VincentTUHH/uvms/testbench_construction/Vincent-3.dxf

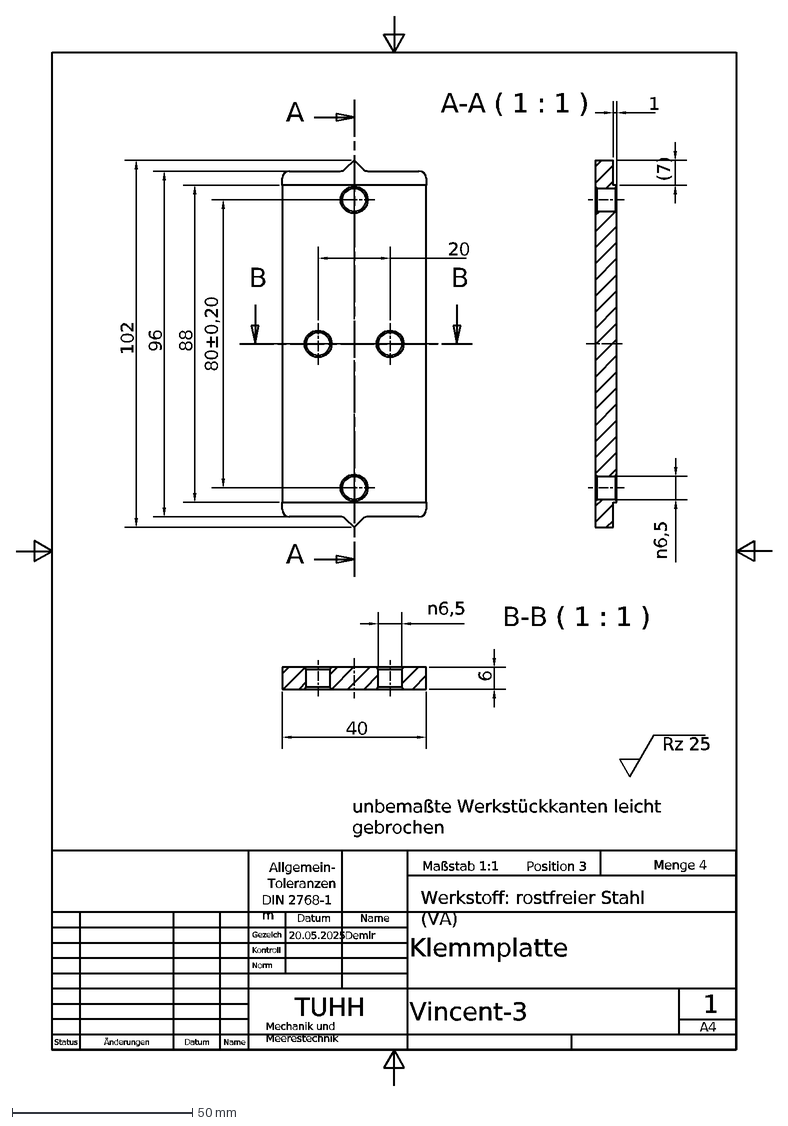
[picture p1: CAD file, 2025-09-16]
testbench_construction/Vincent-3.dxf
1
A4
Klemmplatte
Vincent-3
20.05.2025
Demir
Status
Änderungen
Datum
Name
Gezeich
Kontroll
Norm
80±0,20
20
102
96
A
A-A ( 1 : 1 )
(7)
88
B
B-B ( 1 : 1 )
6
Werkstoff: rostfreier Stahl (VA)
TUHH
DIN 2768-1 m
Maßstab 1:1
Toleranzen
Menge 4
Allgemein-
Position 3
Mechanik und Meerestechnik
unbemaßte Werkstückkanten leicht gebrochen
Rz 25
40
