VincentTUHH/uvms/testbench_construction/item_41901_profil-6-30x30-natur_600_hoch.step

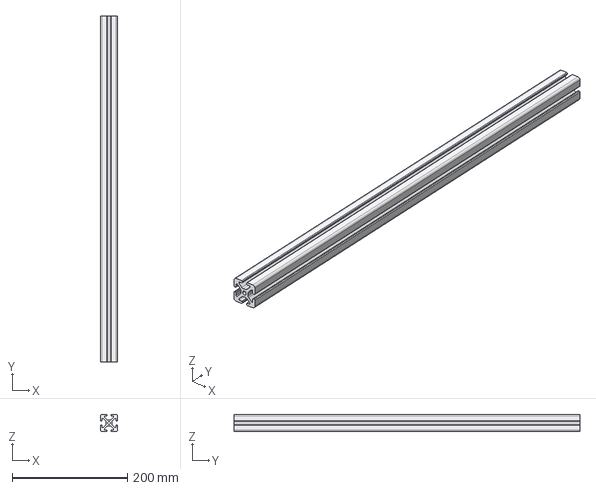
[picture p2: CAD file, 2025-09-16]
testbench_construction/item_41901_profil-6-30x30-natur_600_hoch.step
30.0 x 600.0 x 30.0 mm
