VincentTUHH/uvms/(list of files, cad)

Other CAD files:
testbench_construction/Vincent-4.dwg
testbench_construction/Vincent-1.dwg
testbench_construction/Vincent-8.dwg
testbench_construction/Vincent-5.dwg
testbench_construction/Vincent-6.dwg
testbench_construction/Vincent-2.dwg
testbench_construction/Vincent-7.dwg
testbench_construction/Abdeckkappe-40x40x4.ipt
testbench_construction/Deckel-1.ipt
testbench_construction/Deckel-2.ipt
testbench_construction/Fuss.iam
testbench_construction/Gleitbalken.ipt
testbench_construction/Hîhenverstellung-1.iam
testbench_construction/Hîhenverstellung-2.iam
testbench_construction/Klemmplatte.ipt
testbench_construction/Magnet.ipt
testbench_construction/Magnethalter.ipt
testbench_construction/Platte-1.ipt
testbench_construction/Platte-2.ipt
testbench_construction/Profil-40x40x1400.ipt
testbench_construction/Rasterbalken.ipt
testbench_construction/Referenzplatte.ipt
testbench_construction/Segment-Bodenplatte.ipt
testbench_construction/Teleskop-Hilfsvorrichtung.dwg
testbench_construction/Teleskop-Hilfsvorrichtung.iam
testbench_construction/Vincent-3.dwg
