VincentTUHH/uvms/testbench_construction/Vincent-1.pdf

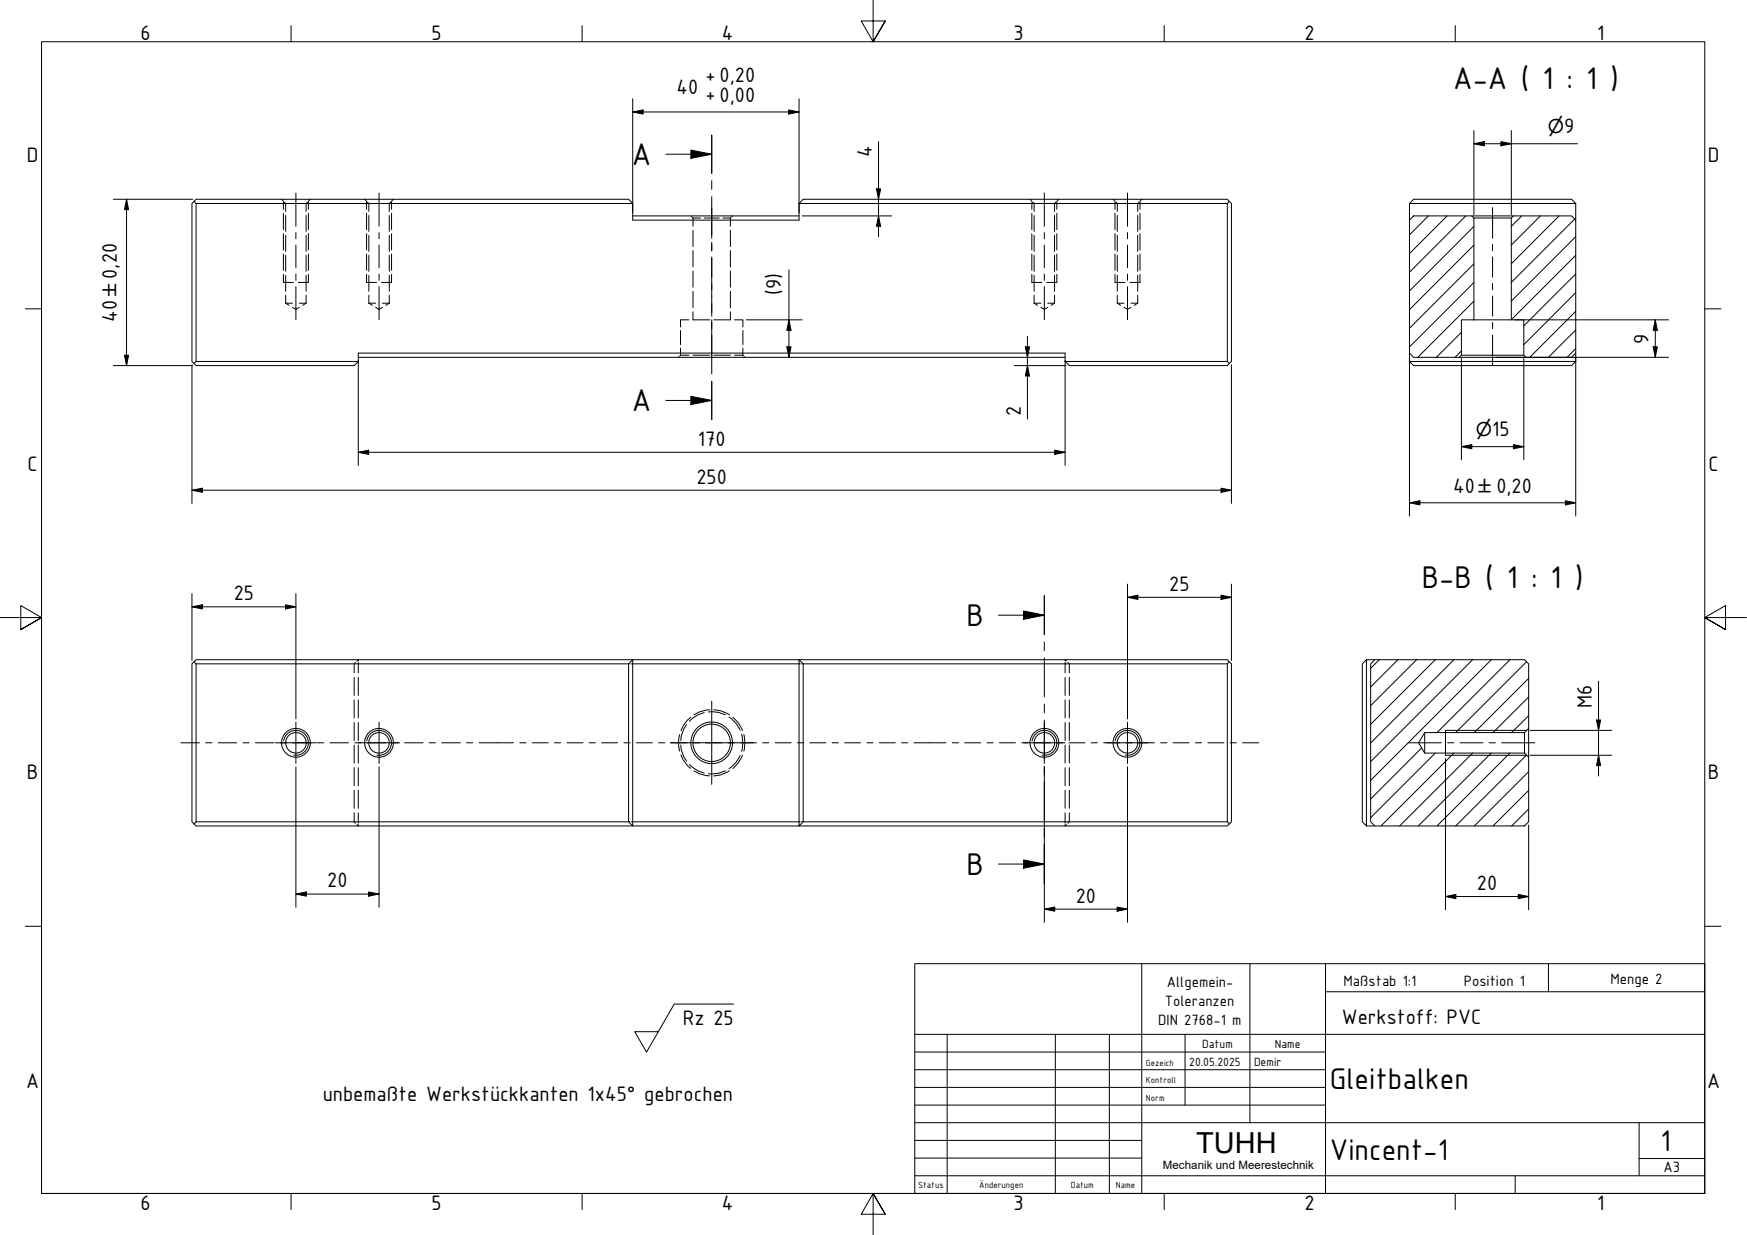
[picture p5: page 1]
DIN 2768-1 m; Maßstab 1:1; Position 1; Menge 2; Werkstoff: PVC

Datum | Name | Gleitbalken

Gezeich | 20.05.2025 | Demir

Kontroll

unbemaßte Werkstückkanten 1x45° gebrochen

Norm

Mechanik und Meerestechnik
