VincentTUHH/uvms/testbench_construction/Vincent-2.pdf

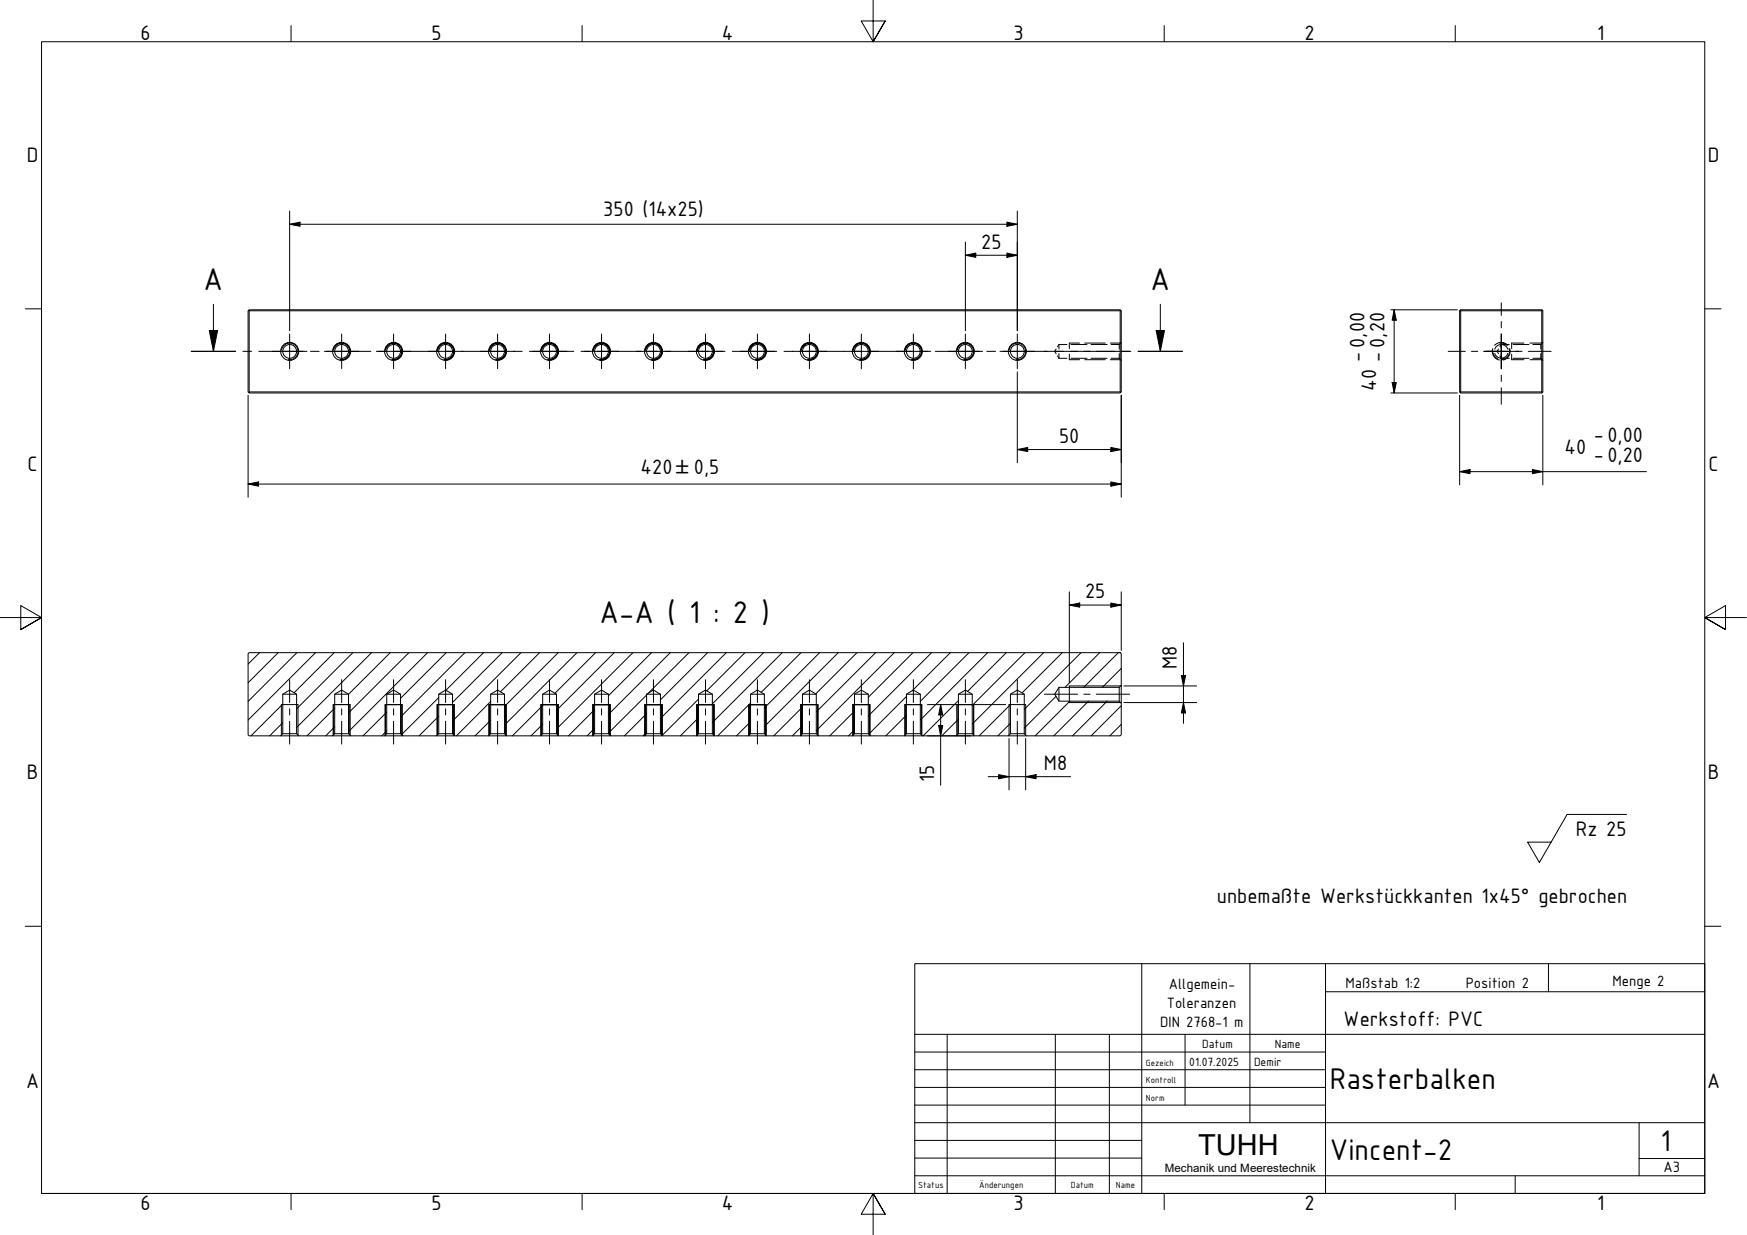
[picture p6: page 1]
Werkstoff: PVC; Menge 2; DIN 2768-1 m; Maßstab 1:2; Position 2

unbemaßte Werkstückkanten 1x45° gebrochen

Datum | Name | Rasterbalken

Gezeich | 01.07.2025 | Demir

Kontroll

Norm

Mechanik und Meerestechnik
