VincentTUHH/uvms/testbench_construction/Vincent-3.pdf

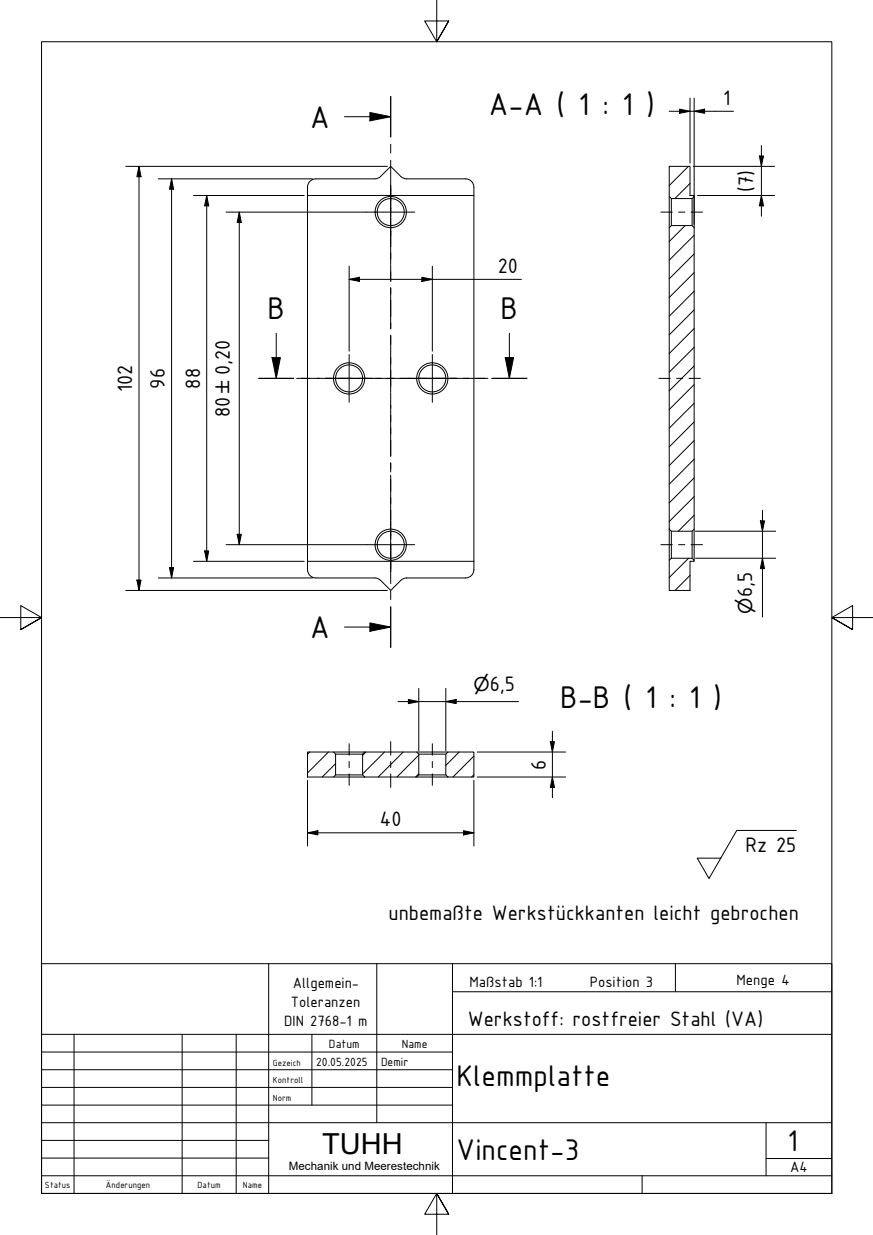
[picture p7: page 1]
DIN 2768-1 m; Allgemein-; Position 3; Menge 4

unbemaßte Werkstückkanten leicht gebrochen

Maßstab 1:1
Werkstoff: rostfreier Stahl (VA)

Datum | Name | Klemmplatte

Gezeich | 20.05.2025 | Demir

Kontroll

Norm

Mechanik und Meerestechnik
