VincentTUHH/uvms/testbench_construction/Vincent-4.pdf

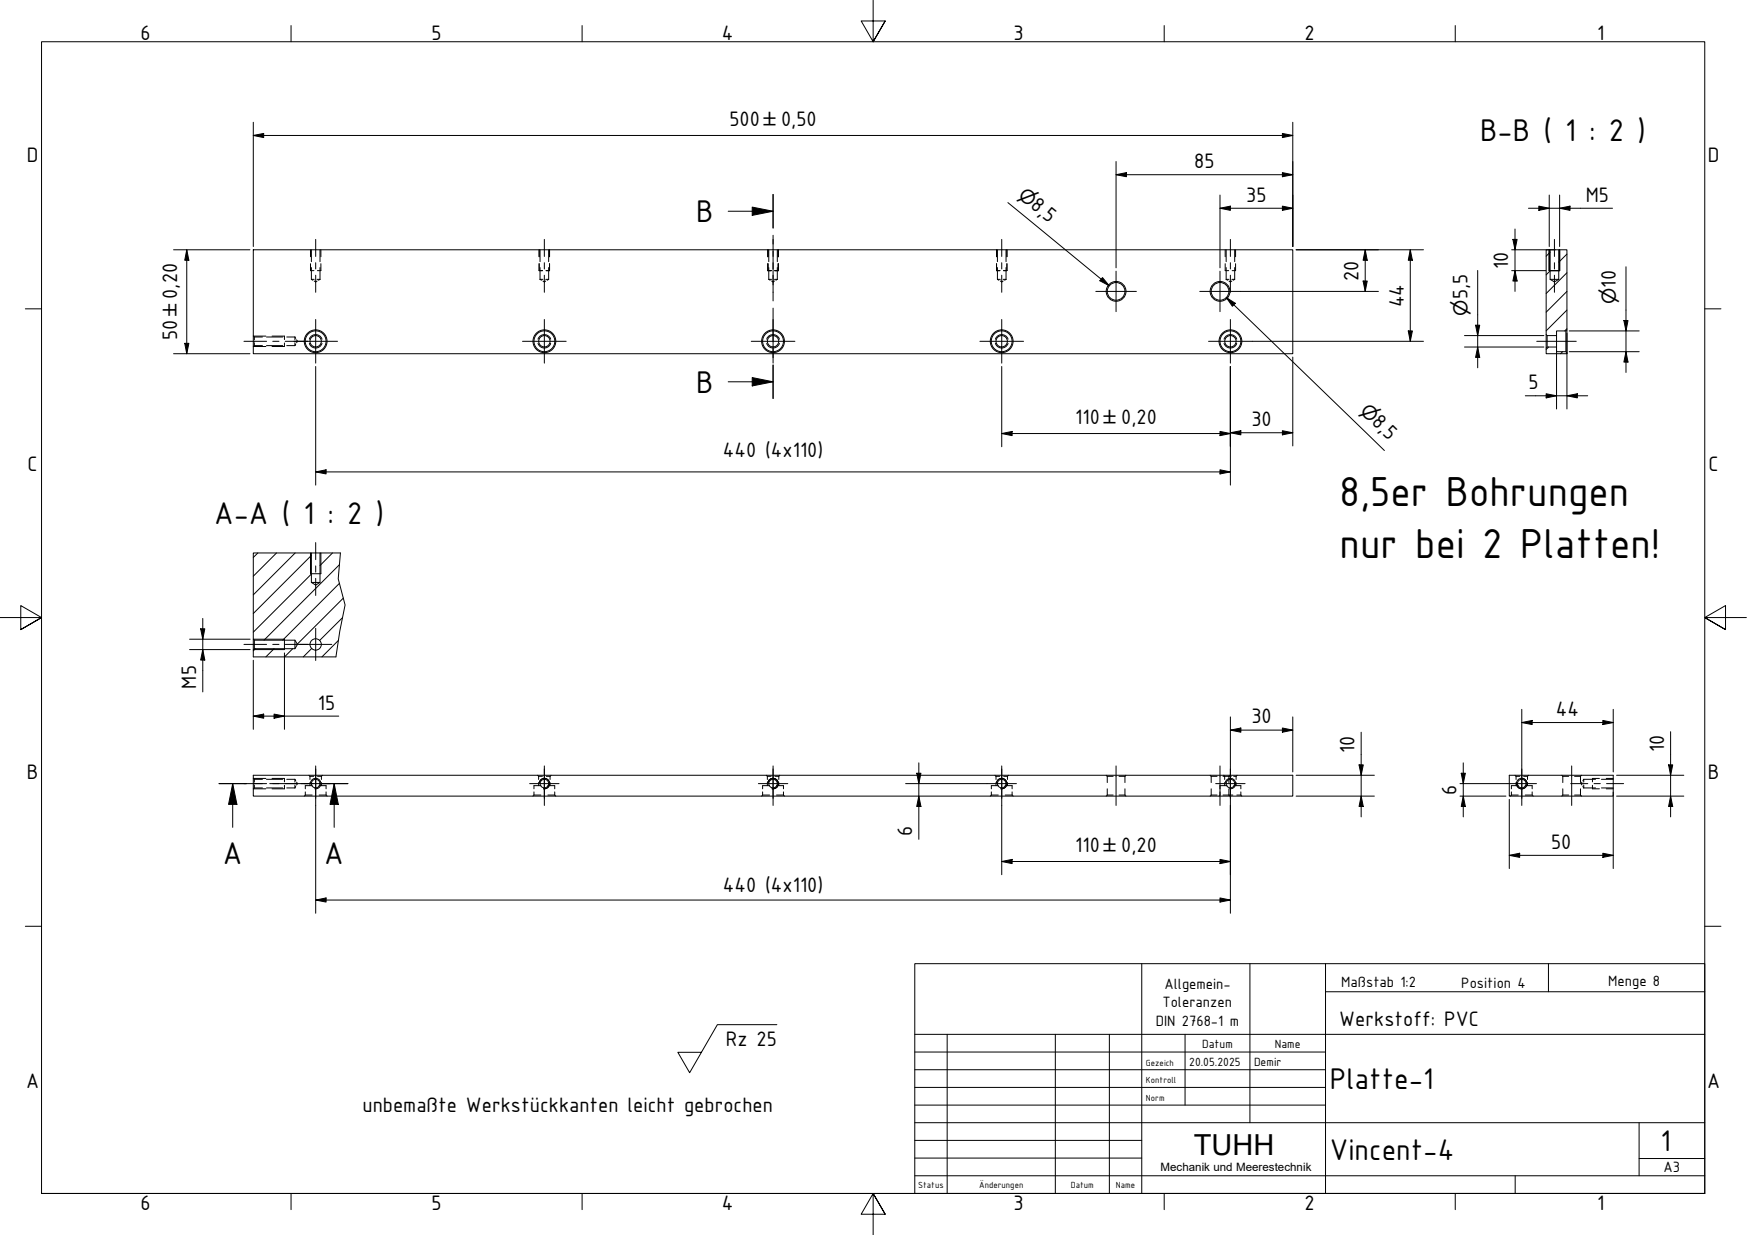
[picture p8: page 1]
DIN 2768-1 m; Werkstoff: PVC; Maßstab 1:2; Position 4; Menge 8

8,5er Bohrungen
nur bei 2 Platten!

Datum | Name | Platte-1

Gezeich | 20.05.2025 | Demir

Kontroll

Norm

unbemaßte Werkstückkanten leicht gebrochen

Mechanik und Meerestechnik
