VincentTUHH/uvms/testbench_construction/Vincent-5.pdf

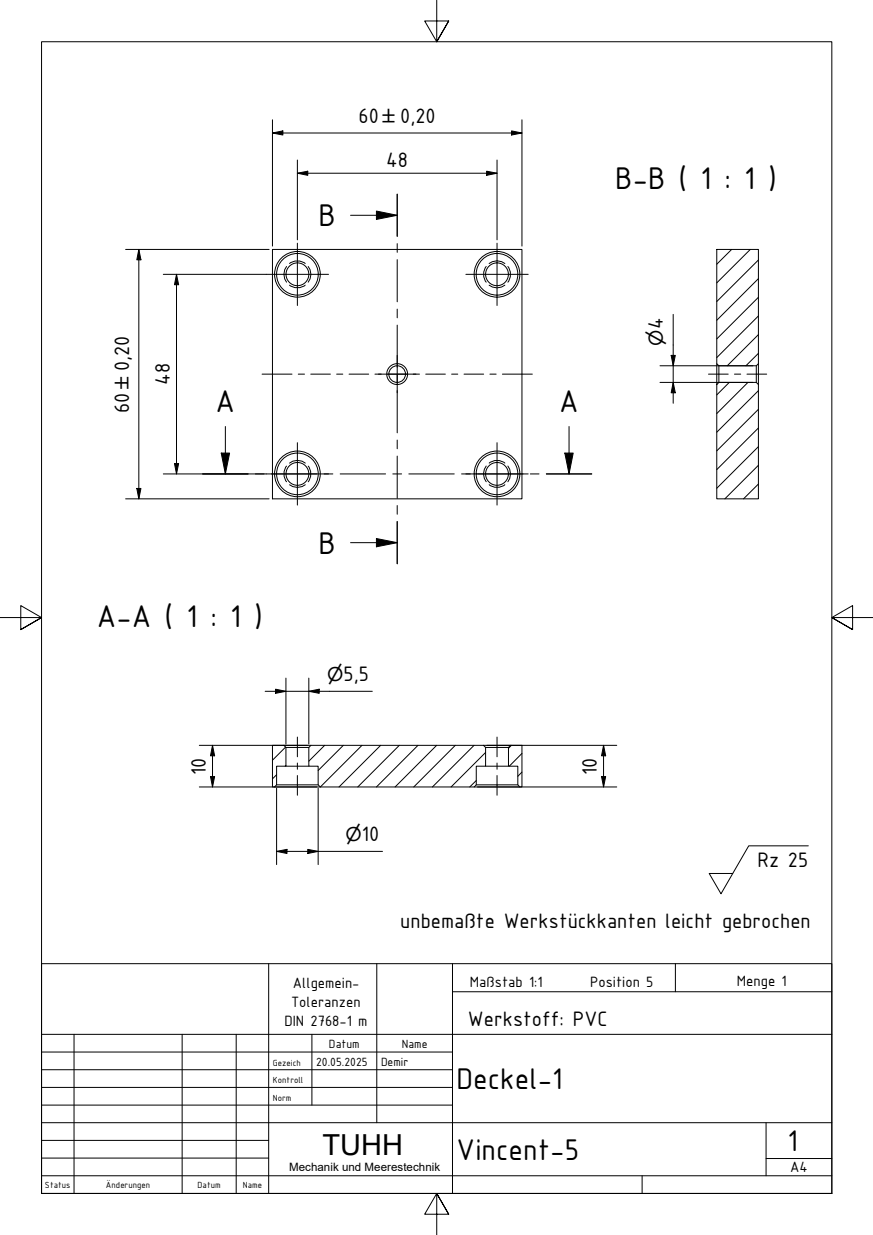
[picture p9: page 1]
DIN 2768-1 m; Werkstoff: PVC; Maßstab 1:1; Position 5; Menge 1

unbemaßte Werkstückkanten leicht gebrochen

Datum | Name | Deckel-1

Gezeich | 20.05.2025 | Demir

Kontroll

Norm

Mechanik und Meerestechnik
