VincentTUHH/uvms/testbench_construction/Vincent-6.pdf

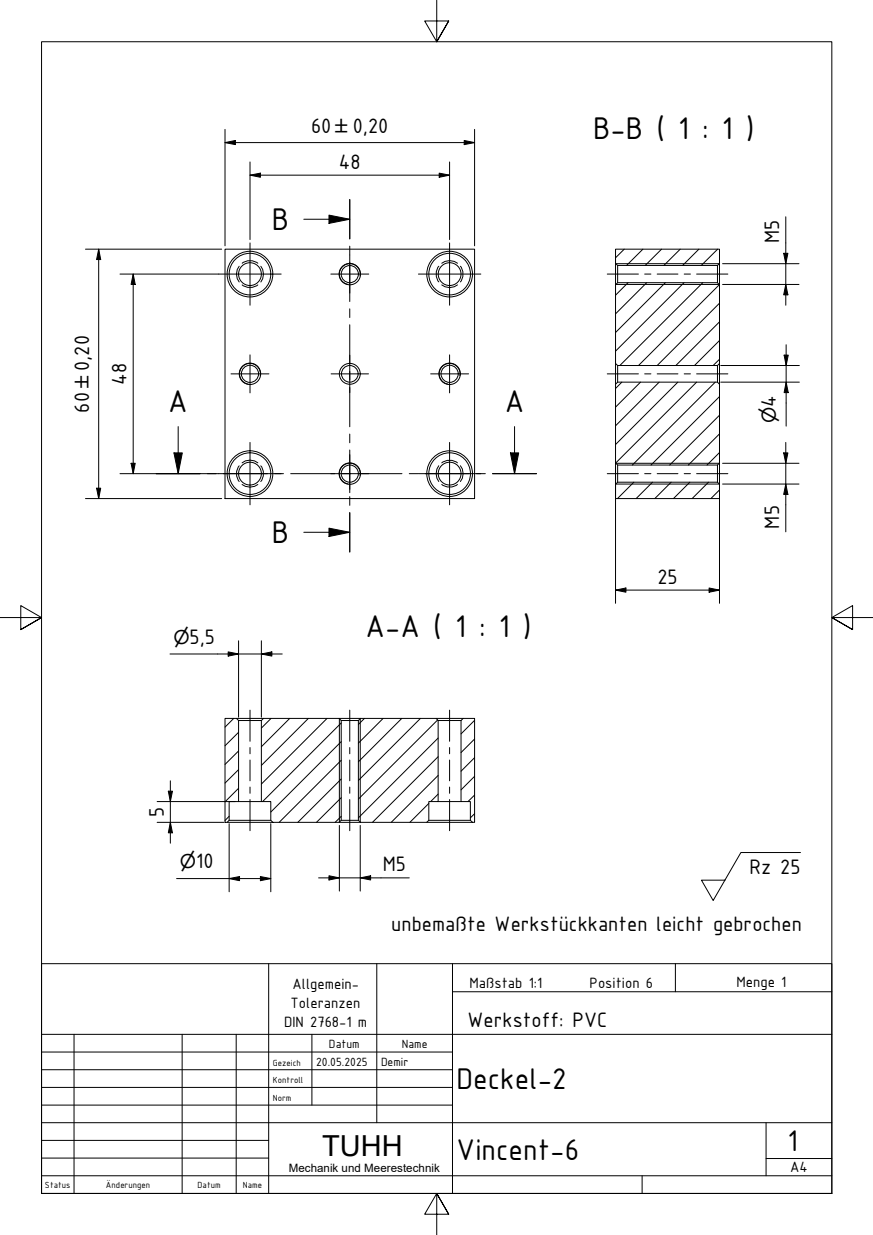
[picture p10: page 1]
Maßstab 1:1; Position 6; DIN 2768-1 m; Menge 1; Werkstoff: PVC

unbemaßte Werkstückkanten leicht gebrochen

Datum | Name | Deckel-2

Gezeich | 20.05.2025 | Demir

Kontroll

Norm

Mechanik und Meerestechnik
