VincentTUHH/uvms/testbench_construction/Vincent-7.pdf

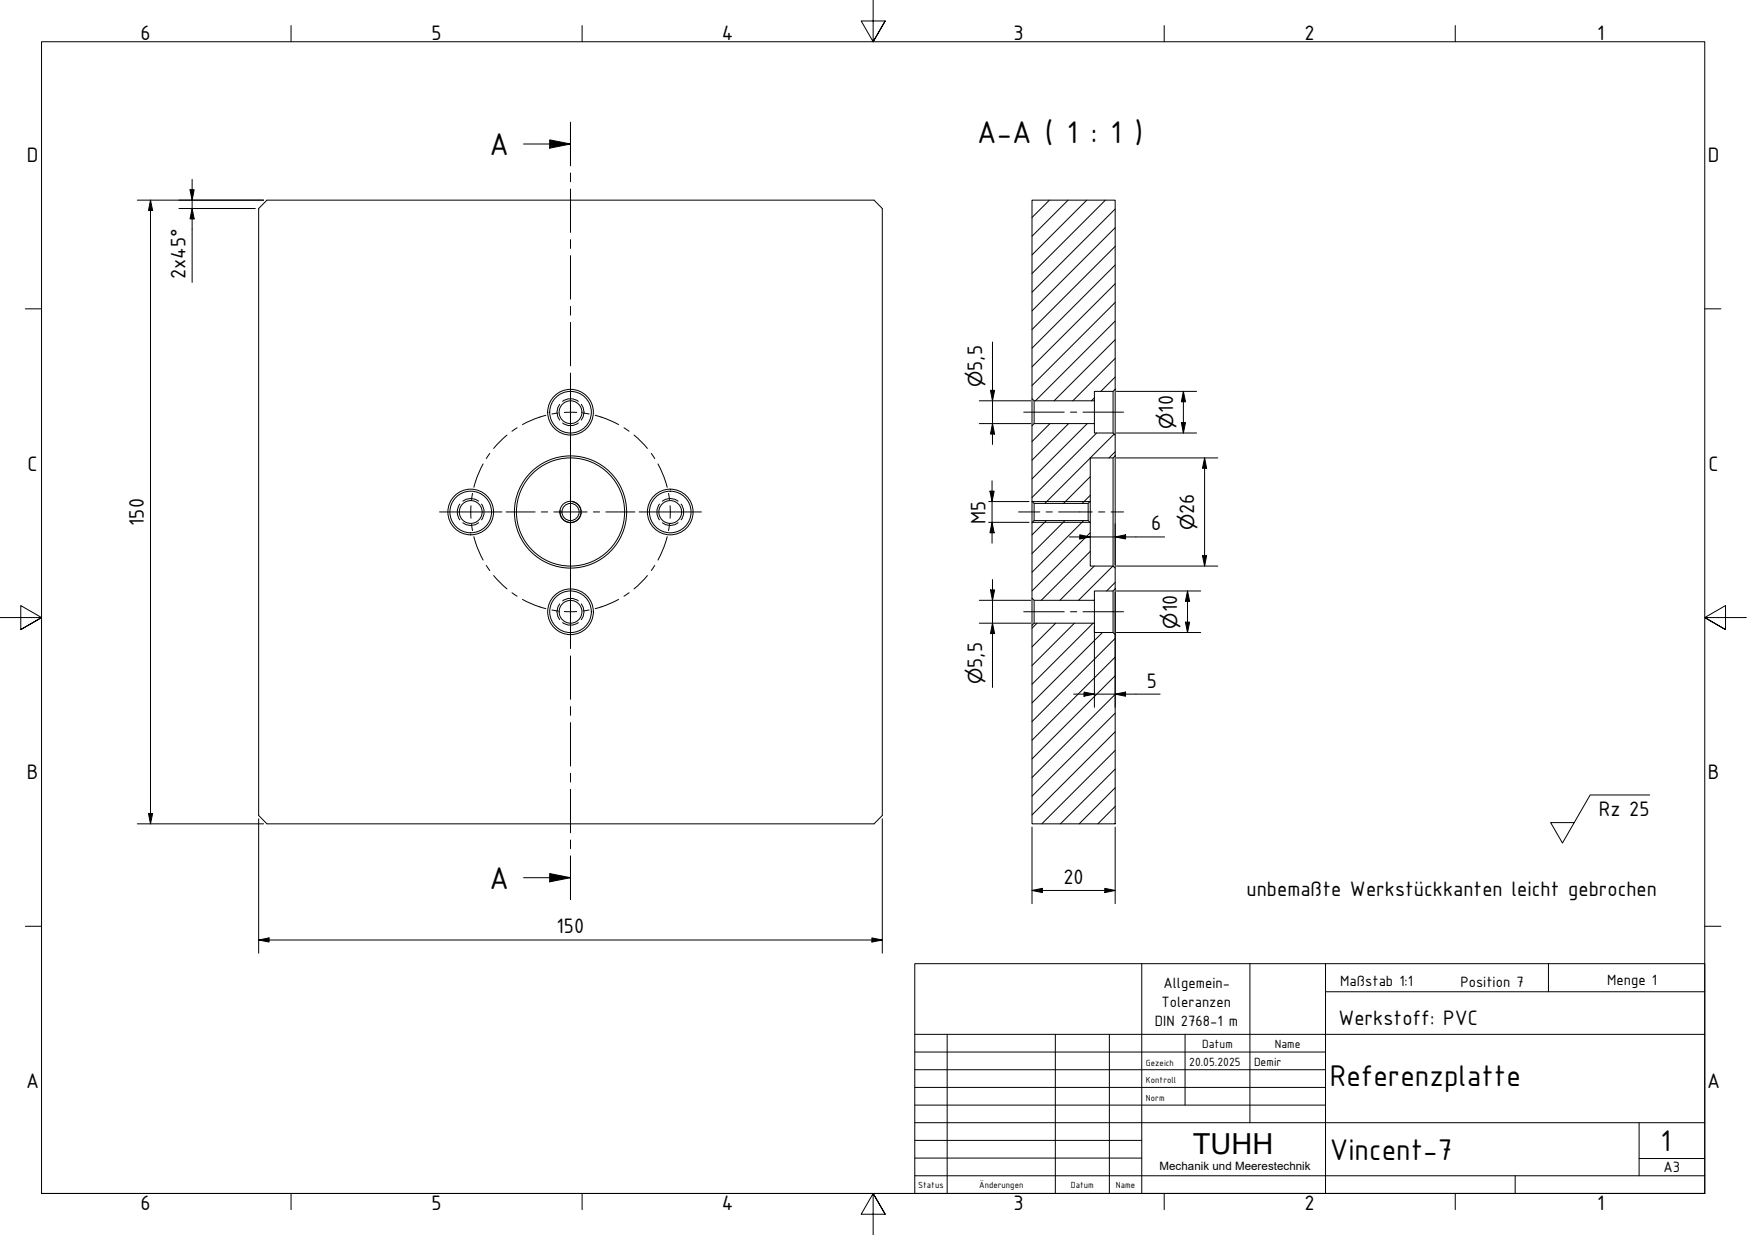
[picture p11: page 1]
Allgemein-; Position 7; Menge 1; Werkstoff: PVC; DIN 2768-1 m; Maßstab 1:1

unbemaßte Werkstückkanten leicht gebrochen

Datum | Name | Referenzplatte

Gezeich | 20.05.2025 | Demir

Kontroll

Norm

Mechanik und Meerestechnik
