VincentTUHH/uvms/testbench_construction/Vincent-8.pdf

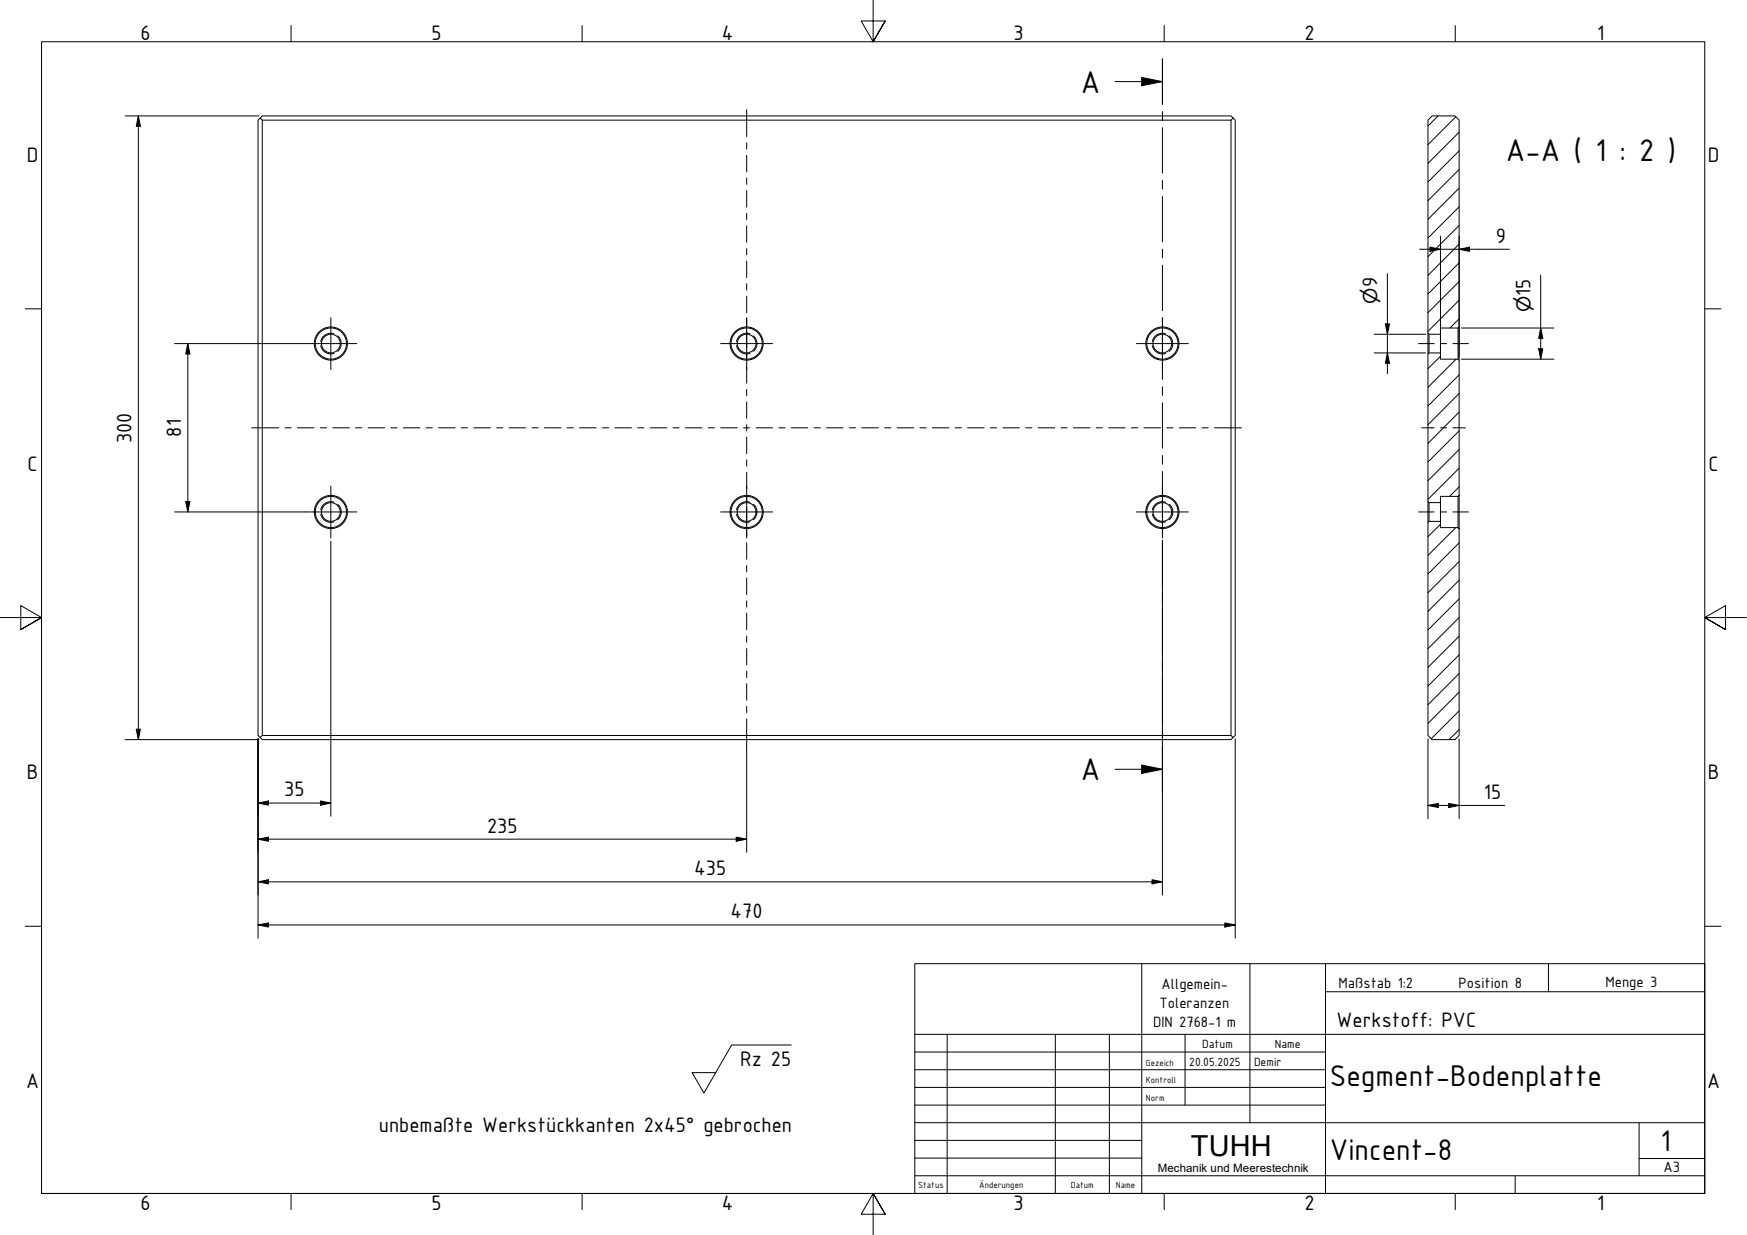
[picture p12: page 1]
Maßstab 1:2; Position 8; DIN 2768-1 m; Menge 3; Werkstoff: PVC

Datum | Name | Segment-Bodenplatte

Gezeich | 20.05.2025 | Demir

Kontroll

Norm

unbemaßte Werkstückkanten 2x45° gebrochen

Mechanik und Meerestechnik
