VincentTUHH/uvms/uvms_kinematic_ctrl/nodes/uvms_switching_kin_ctrl_node.hpp

// Copyright (C) 2023  Niklas Trekel
// Copyright (C) 2024  Vincent Lenz

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
#ifndef UVMS_KINEMATIC_CTRL_UVMS_SWITCHING_KIN_CTRL_NODE_H
#define UVMS_KINEMATIC_CTRL_UVMS_SWITCHING_KIN_CTRL_NODE_H
#include <eigen3/Eigen/Dense>
#include <geometry_msgs/msg/pose_stamped.hpp>
#include <geometry_msgs/msg/twist_stamped.hpp>
#include <nav_msgs/msg/odometry.hpp>
#include <rclcpp/rclcpp.hpp>
#include <sensor_msgs/msg/joint_state.hpp>
#include <std_msgs/msg/float64.hpp>
#include <std_msgs/msg/int64.hpp>

#include "alpha_msgs/msg/joint_data.hpp"
#include "hippo_common/convert.hpp"
#include "hippo_common/param_utils.hpp"
#include "hippo_common/tf2_utils.hpp"
#include "hippo_control_msgs/msg/actuator_setpoint.hpp"
#include "hippo_control_msgs/msg/control_target.hpp"
#include "hippo_control_msgs/msg/velocity_control_target.hpp"
#include "uvms_common/ros_param_utils.hpp"
#include "uvms_switching_kin_ctrl_node_configuration_space.hpp"
#include "uvms_kinematic_ctrl/kin_ctrl_node_interface.hpp"
#include "uvms_msgs/msg/control_target_prediction.hpp"

namespace uvms_kin_ctrl {
using std::placeholders::_1;

/**
 * @brief Switches between startup positioning and end-effector trajectory tracking.
 *
 * During startup, configuration-space control first moves the AUV to its desired
 * initial pose and then moves the manipulator to its desired joint configuration.
 * This establishes the initial UVMS configuration for the pick-and-place task.
 *
 * After the startup setpoints time out, the node switches to end-effector control,
 * which tracks the desired end-effector trajectory during the manipulation phase.
 *
 * Unlike the non-switching controller, this node keeps the startup controller
 * connected. A new configuration-space setpoint can therefore restart the
 * initialization sequence, allowing repeated pick-and-place cycles without
 * restarting the node.
 *
 * The switching changes only the active control mode, not the underlying
 * kinematic control laws.
 */

class UVMSSwitchingKinematicControlNode : public rclcpp::Node {
 public:
  UVMSSwitchingKinematicControlNode();

 private:
  void initTimers();
  void initController();
  void declareParams();
  void initPublishers();
  void initSubscriptions();
  alpha_msgs::msg::JointData zeroManipulatorMsg(const rclcpp::Time& _stamp);
  void onSetpointTimeout();
  void onSetpointTarget(const hippo_control_msgs::msg::ControlTarget::SharedPtr _msg);
  void onJointState(const sensor_msgs::msg::JointState::SharedPtr _msg);
  void onOdometry(const nav_msgs::msg::Odometry::SharedPtr _msg);
  void onControllerStatusUpdate();
  void publishControlCmds();

  std::mutex mutex_;

  std_msgs::msg::Int64 msg_controller_status_;

  //////////////////////////////////////////////////////////////////////////////
  // ros params
  //////////////////////////////////////////////////////////////////////////////

  UVMSKinematicControlInterface* controller_interface_;
  nav_msgs::msg::Odometry last_odometry_;
  sensor_msgs::msg::JointState last_joint_state_;
  bool setpoint_timed_out_{false};
  bool state_timed_out_{false};

  bool got_first_setpoint_{false};
  bool got_first_auv_state_{false};
  bool got_first_manipulator_state_{false};
  bool publish_on_joint_state_;

  rclcpp::TimerBase::SharedPtr setpoint_timeout_timer_;
  rclcpp::TimerBase::SharedPtr controller_status_update_timer_;

  bool got_first_time_stamp_{false};
  rclcpp::Time last_stamp_;

  //////////////////////////////////////////////////////////////////////////////
  // publishers
  //////////////////////////////////////////////////////////////////////////////
  rclcpp::Publisher<alpha_msgs::msg::JointData>::SharedPtr manipulator_cmd_pub_;
  rclcpp::Publisher<hippo_control_msgs::msg::VelocityControlTarget>::SharedPtr
      auv_vel_cmd_pub_;
  rclcpp::Publisher<geometry_msgs::msg::PoseStamped>::SharedPtr eef_pose_pub_;
  rclcpp::Publisher<std_msgs::msg::Int64>::SharedPtr controller_status_pub_;
  //////////////////////////////////////////////////////////////////////////////
  // subscriptions
  //////////////////////////////////////////////////////////////////////////////

  rclcpp::Subscription<sensor_msgs::msg::JointState>::SharedPtr
      state_sub_manipulator_;
  rclcpp::Subscription<nav_msgs::msg::Odometry>::SharedPtr odom_sub_auv_;
  rclcpp::Subscription<hippo_control_msgs::msg::ControlTarget>::SharedPtr eef_traj_sub_;

  UVMSSwitchingKinematicConfigurationControl* startup_controller_;
  int controller_status_ = ControllerStatus::undeclared;
};

}  // namespace uvms_kin_ctrl

#endif  // UVMS_KINEMATIC_CTRL_UVMS_SWITCHING_KIN_CTRL_NODE_H
