VincentTUHH/uvms/uvms_kinematic_ctrl/nodes/uvms_switching_kin_ctrl_node_configuration_space.hpp

// Copyright (C) 2023  Niklas Trekel
// Copyright (C) 2024  Vincent Lenz

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
#ifndef UVMS_TRAJECTORY_GEN_UVMS_SWITCHING_KIN_CTRL_NODE_CONFIGURATION_SPACE_HPP
#define UVMS_TRAJECTORY_GEN_UVMS_SWITCHING_KIN_CTRL_NODE_CONFIGURATION_SPACE_HPP
#include <eigen3/Eigen/Dense>
#include <geometry_msgs/msg/twist_stamped.hpp>
#include <nav_msgs/msg/odometry.hpp>
#include <rclcpp/rclcpp.hpp>

#include "alpha_ctrl/joint_kinematic_control_interface.hpp"
#include "alpha_msgs/msg/joint_data.hpp"
#include "bluerov_ctrl/attitude_skew_symmetric_p_module_interface.hpp"
#include "bluerov_ctrl/position_p_module_interface.hpp"
#include "hippo_common/tf2_utils.hpp"
#include "hippo_control_msgs/msg/velocity_control_target.hpp"
#include "uvms_msgs/msg/uvms_control_target.hpp"

namespace uvms_kin_ctrl {
using rcl_interfaces::msg::SetParametersResult;
using std::placeholders::_1;

enum ControllerStatus {
  undeclared = -1,
  joint_space_control = 1,
  eef_control = 2
};

/**
 * @brief Controls the sequential initialization of the UVMS.
 *
 * The controller first moves the AUV to its desired initial pose while holding
 * the manipulator configuration. It then moves the manipulator joints to their
 * desired initial configuration.
 *
 * Once configuration-space setpoints stop arriving, control is handed over to
 * the end-effector controller for trajectory tracking. Because the setpoint
 * subscription remains active, a new initialization sequence can be started
 * later for another pick-and-place cycle.
 */
class UVMSSwitchingKinematicConfigurationControl {
 public:
  UVMSSwitchingKinematicConfigurationControl();

  void setControllerStatusPtr(int *controller_status_ptr) {
    controller_status_ptr_ = controller_status_ptr;
  }

  void initialize(rclcpp::Node *node_ptr);

//   void resetConnections();

  void initializeParameterCallbacks();

  void setManipulatorCmdPublisherPtr(
      const rclcpp::Publisher<alpha_msgs::msg::JointData>::SharedPtr &pub) {
    manipulator_cmd_pub_ = pub;
  }
  void setAUVCmdPublisherPtr(
      const rclcpp::Publisher<hippo_control_msgs::msg::VelocityControlTarget>::SharedPtr
          &pub) {
    auv_vel_cmd_pub_ = pub;
  }

  void publishControlCommands(
      const nav_msgs::msg::Odometry &auv_msg,
      const sensor_msgs::msg::JointState &manipulator_msg);

 private:
  void initController();

  void initTimers();

  void initSubscriptions();

  alpha_msgs::msg::JointData zeroManipulatorMsg(const rclcpp::Time &_stamp);

  void onSetpointTimeout();

  void onSetpointTarget(
      const uvms_msgs::msg::UVMSControlTarget::SharedPtr _msg);

  std::mutex mutex_;

  //////////////////////////////////////////////////////////////////////////////
  // ros params
  //////////////////////////////////////////////////////////////////////////////

  rclcpp::Node *node_ptr_;
  nav_msgs::msg::Odometry last_odometry_;
  sensor_msgs::msg::JointState last_joint_state_;
//   bool setpoint_timed_out_{false};

  bool got_first_setpoint_{false};

  rclcpp::TimerBase::SharedPtr setpoint_timeout_timer_;

  /// Publishers
  rclcpp::Publisher<alpha_msgs::msg::JointData>::SharedPtr manipulator_cmd_pub_;
  rclcpp::Publisher<hippo_control_msgs::msg::VelocityControlTarget>::SharedPtr
      auv_vel_cmd_pub_;

  /// Subscriptions
  rclcpp::Subscription<uvms_msgs::msg::UVMSControlTarget>::SharedPtr
      setpoint_sub_;

  /// controller interfaces
  alpha_ctrl::JointKinematicControlInterface *manipulator_controller_interface_;
  bluerov_ctrl::PosPModuleInterface *auv_position_controller_interface_;
  bluerov_ctrl::AttSkewSymmetricPModuleInterface
      *auv_attitude_controller_interface_;

  int *controller_status_ptr_;
};
}  // namespace uvms_kin_ctrl

#endif  // UVMS_TRAJECTORY_GEN_UVMS_SWITCHING_KIN_CTRL_NODE_CONFIGURATION_SPACE_HPP
