VincentTUHH/uvms/(commit log)

2025-04-11 switch from christmas video planner to pick and place planner
2025-04-11 fixed problem in planner
    [uvms_planner_node.hpp]
2025-09-16 aaded empty folder for testbench CAD files
2025-09-16 Added test bench CAD files
    [Abdeckkappe-40x40x4.ipt, Deckel-1.ipt, Deckel-2.ipt, Fuss.iam, Gleitbalken.ipt, Hîhenverstellung-1.iam, Hîhenverstellung-2.iam, Klemmplatte.ipt]
2026-07-21 document UVMS planning and trajectory flow
2026-07-21 restore odometry bridge for EKF2 experiments
    Use the PX4 bridge in experiments where EKF2 publishes velocities in the inertial frame while the UVMS framework expects them in the body frame.
