VincentTUHH/uvms/(notices)

Notices in the files:
uvms_kinematic_ctrl/nodes/uvms_switching_kin_ctrl_node.hpp:
This program is free software: you can redistribute it and/or modify
it under the terms of the GNU General Public License as published by
the Free Software Foundation, either version 3 of the License, or
(at your option) any later version.
